Sxyther/BabyGroot_v1-0/README.md

# BabyGroot_v1-0
Babygroot project. Arduino based watering system for indoor plants
