Sxyther/BabyGroot_v1-0/GabyGroot_v1-0.pdf

VCC 7 | AGND 22 | AREF 21

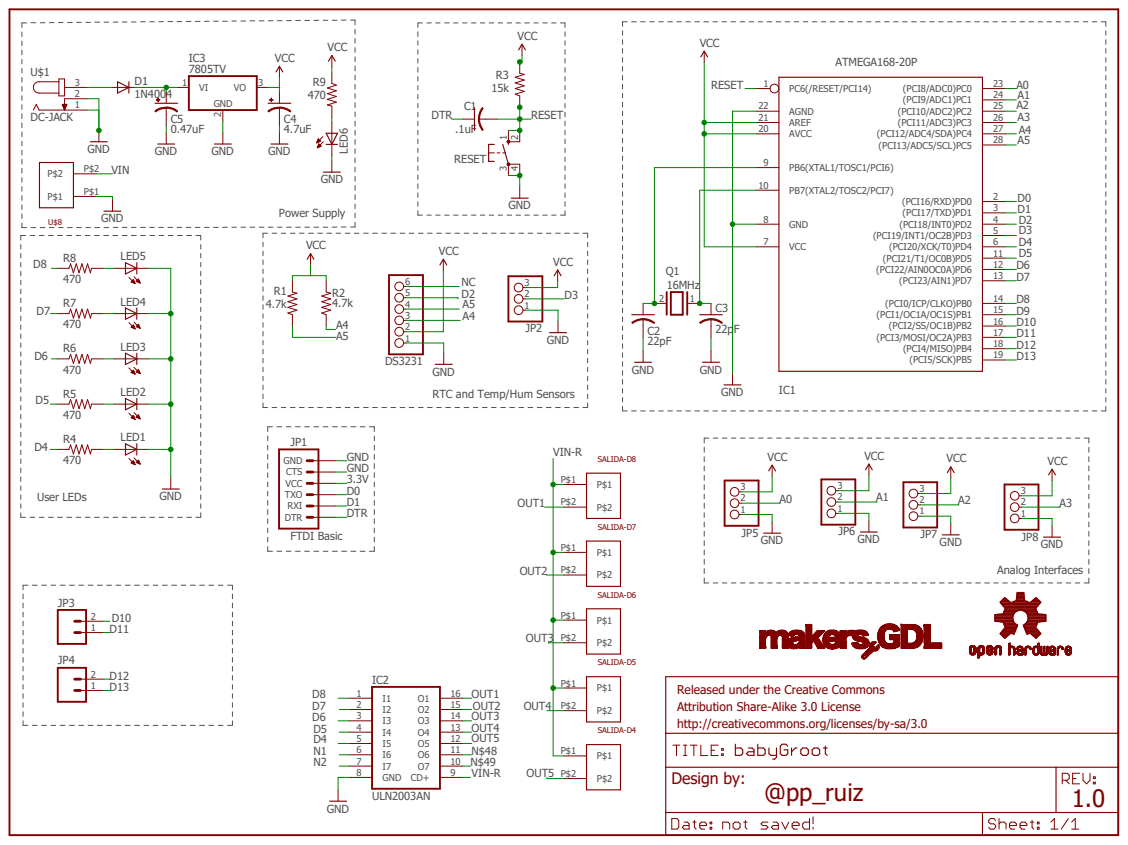
[picture p1: page 1]

GND
RTC and Temp/Hum Sensors

VIN-R
SALIDA-D8 SALIDA-D7 SALIDA-D6 SALIDA-D5

Released under the Creative Commons
Attribution Share-Alike 3.0 License
http://creativecommons.org/licenses/by-sa/3.0
