Sxyther/BabyGroot_v1-0/babyGroot.brd

## EAGLE design babyGroot.brd (2018-05-31)

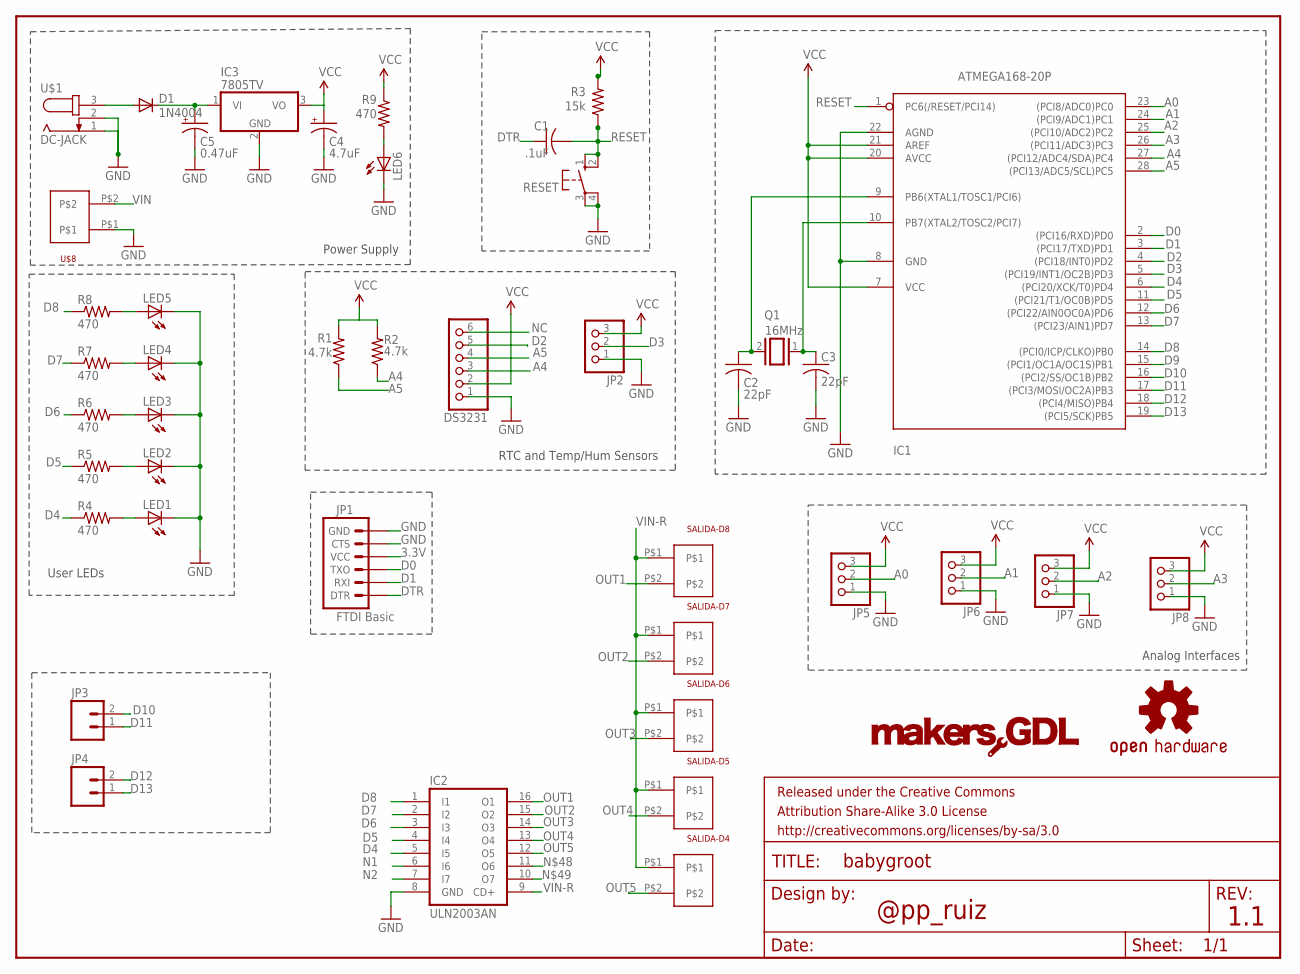
[picture p2: schematic babyGroot.sch]

Parts:
C1: .1uF; C025-024X044
C2, C3: 22pF; C025-024X044
C4: 4.7uF; E2,5-6E
C5: 0.47uF; E2,5-6E
D1: 1N4004; DO41-10
DS3231: PINHD-1X6; 1X06
FRAME1: FRAME-LETTER; CREATIVE_COMMONS
IC1: ATMEGA168-20P; DIL28-3
IC2: ULN2003AN; DIL16
IC3: 7805TV; TO220V
JP1: FTDI Basic; 1X06
JP2, JP5, JP6, JP7, JP8: PINHD-1X3; 1X03
JP3, JP4: M02PTH; 1X02
LED1, LED2, LED3, LED4, LED5, LED6: LED3MM
Q1: 16MHz; QS
R1, R2: 4.7k; 0204V
R3: 15k; 0204V
R4, R5, R6, R7, R8, R9: 470; 0204V
RESET: 10-XX; B3F-10XX
SALIDA-D4, SALIDA-D5, SALIDA-D6, SALIDA-D7, SALIDA-D8: 2POSHEADER-0.5MM; 2PIN-0.5MM
U$1: DC-JACK; SPC4078
U$3: OSHW-LOGOS; OSHW-LOGO-S
U$4: MAKERSGDLLOGO-SMALL; MAKERSGGL-SMALL
U$8: 2POSHEADER-0.5MM; 2PIN-0.5MM

Connections:
3.3V: C4.+, DS3231.2, IC1.7 (VCC), IC1.20 (AVCC), IC1.21 (AREF), IC3.3 (VO), JP1.4 (VCC), JP2.3, JP5.3, JP6.3, JP7.3, JP8.3, R1.2, R2.2, R3.2, R9.1
A0: IC1.23 ((PCI8/ADC0)PC0), JP5.2
A1: IC1.24 ((PCI9/ADC1)PC1), JP6.2
A2: IC1.25 ((PCI10/ADC2)PC2), JP7.2
A3: IC1.26 ((PCI11/ADC3)PC3), JP8.2
A4: DS3231.3, IC1.27 ((PCI12/ADC4/SDA)PC4), R2.1
A5: DS3231.4, IC1.28 ((PCI13/ADC5/SCL)PC5), R1.1
D0: IC1.2 ((PCI16/RXD)PD0), JP1.3 (TXO)
D1: IC1.3 ((PCI17/TXD)PD1), JP1.2 (RXI)
D2: DS3231.5, IC1.4 ((PCI18/INT0)PD2)
D3: IC1.5 ((PCI19/INT1/OC2B)PD3), JP2.2
D4: IC1.6 ((PCI20/XCK/T0)PD4), IC2.5 (I5), R4.1
D5: IC1.11 ((PCI21/T1/OC0B)PD5), IC2.4 (I4), R5.1
D6: IC1.12 ((PCI22/AIN0OC0A)PD6), IC2.3 (I3), R6.1
D7: IC1.13 ((PCI23/AIN1)PD7), IC2.2 (I2), R7.1
D8: IC1.14 ((PCI0/ICP/CLKO)PB0), IC2.1 (I1), R8.1
D9: IC1.15 ((PCI1/OC1A/OC1S)PB1)
D10: IC1.16 ((PCI2/SS/OC1B)PB2), JP3.2
D11: IC1.17 ((PCI3/MOSI/OC2A)PB3), JP3.1
D12: IC1.18 ((PCI4/MISO)PB4), JP4.2
D13: IC1.19 ((PCI5/SCK)PB5), JP4.1
DTR: C1.1, JP1.1 (DTR)
GND: C2.2, C3.2, C4.-, C5.-, DS3231.1, IC1.8 (GND), IC1.22 (AGND), IC2.8 (GND), IC3.2 (GND), JP1.5 (CTS), JP1.6 (GND), JP2.1, JP5.1, JP6.1, JP7.1, JP8.1, LED1.K (C), LED2.K (C), LED3.K (C), LED4.K (C), LED5.K (C), LED6.K (C), RESET.3, RESET.4 (P1), U$1.1, U$1.2, U$8.P$1
N1: IC2.6 (I6)
N2: IC2.7 (I7)
unnamed: C2.1, IC1.9 (PB6(XTAL1/TOSC1/PCI6)), Q1.2
unnamed: C3.1, IC1.10 (PB7(XTAL2/TOSC2/PCI7)), Q1.1
unnamed: LED6.A, R9.2
unnamed: LED5.A, R8.2
unnamed: LED4.A, R7.2
unnamed: LED3.A, R6.2
unnamed: LED2.A, R5.2
unnamed: LED1.A, R4.2
NC: DS3231.6
OUT1: IC2.16 (O1), SALIDA-D8.P$2
OUT2: IC2.15 (O2), SALIDA-D7.P$2
OUT3: IC2.14 (O3), SALIDA-D6.P$2
OUT4: IC2.13 (O4), SALIDA-D5.P$2
OUT5: IC2.12 (O5), SALIDA-D4.P$2
RESET: C1.2, IC1.1 (PC6(/RESET/PCI14)), R3.1, RESET.1 (S), RESET.2 (S1)
VIN: D1.A, U$1.3, U$8.P$2
VIN-R: C5.+, D1.C, IC2.9 (CD+), IC3.1 (VI), SALIDA-D4.P$1, SALIDA-D5.P$1, SALIDA-D6.P$1, SALIDA-D7.P$1, SALIDA-D8.P$1

Notes on the sheet:
User LEDs
@pp_ruiz
1.1
Power Supply
RTC and Temp/Hum Sensors
Analog Interfaces

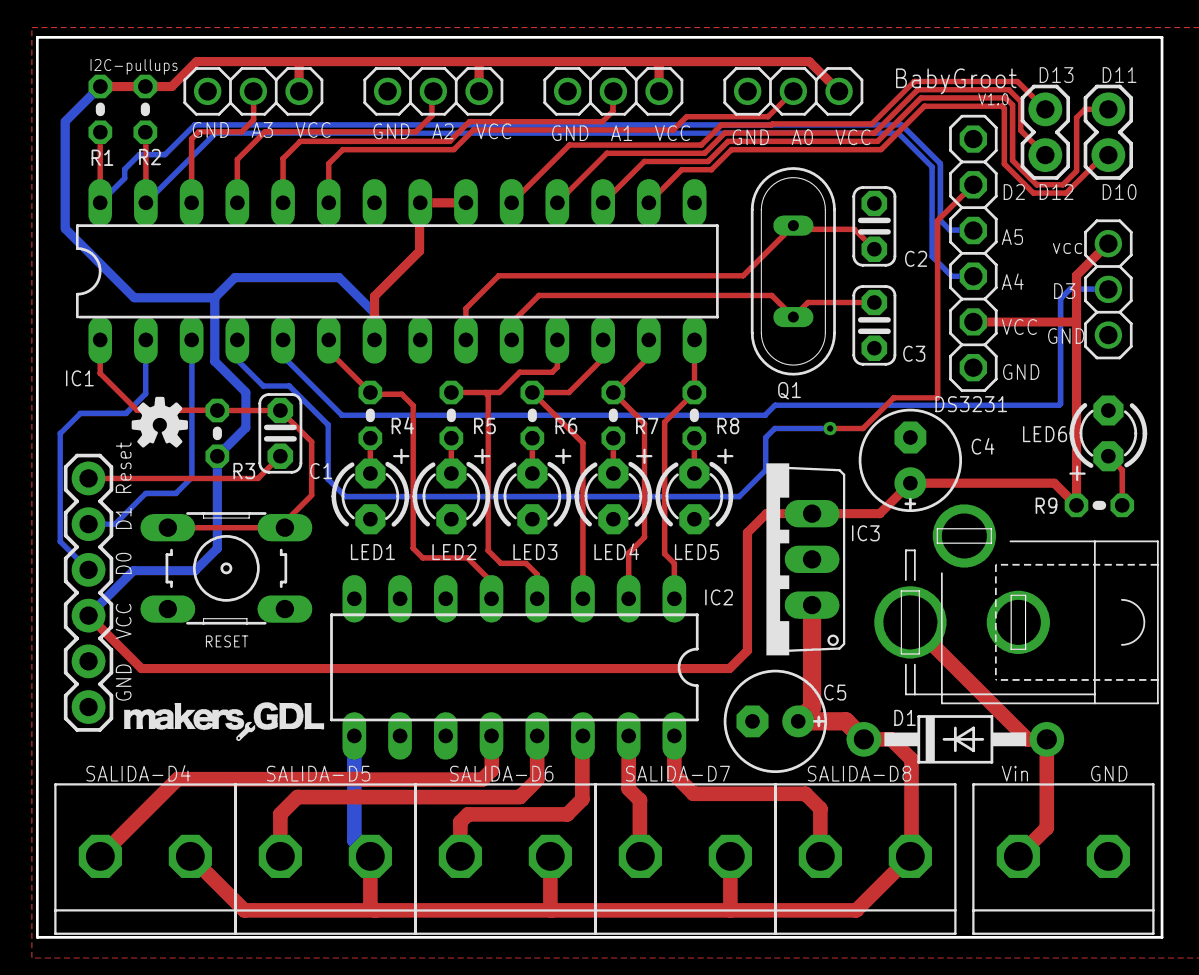
[picture p3: board babyGroot.brd from above]

Board: 2 copper layers, 62.5 x 50.0 mm, 45 parts (0 on the bottom side), 38 nets.
